MayNiklas/AxxSolder/(commit log)

2026-05-30 set LCSC ID where it's obvious
    [AxxSolder.kicad_pcb, AxxSolder.kicad_sch]
2026-05-30 add more LCSC IDs
    [AxxSolder.kicad_sch]
2026-05-31 add LCSC ID's
    [AxxSolder.kicad_sch]
2026-05-31 add additional ID's
    [AxxSolder.kicad_sch]
